mykhayloscherbak/psg14aemu/hw/psg14_emu/psg14_emu.pdf

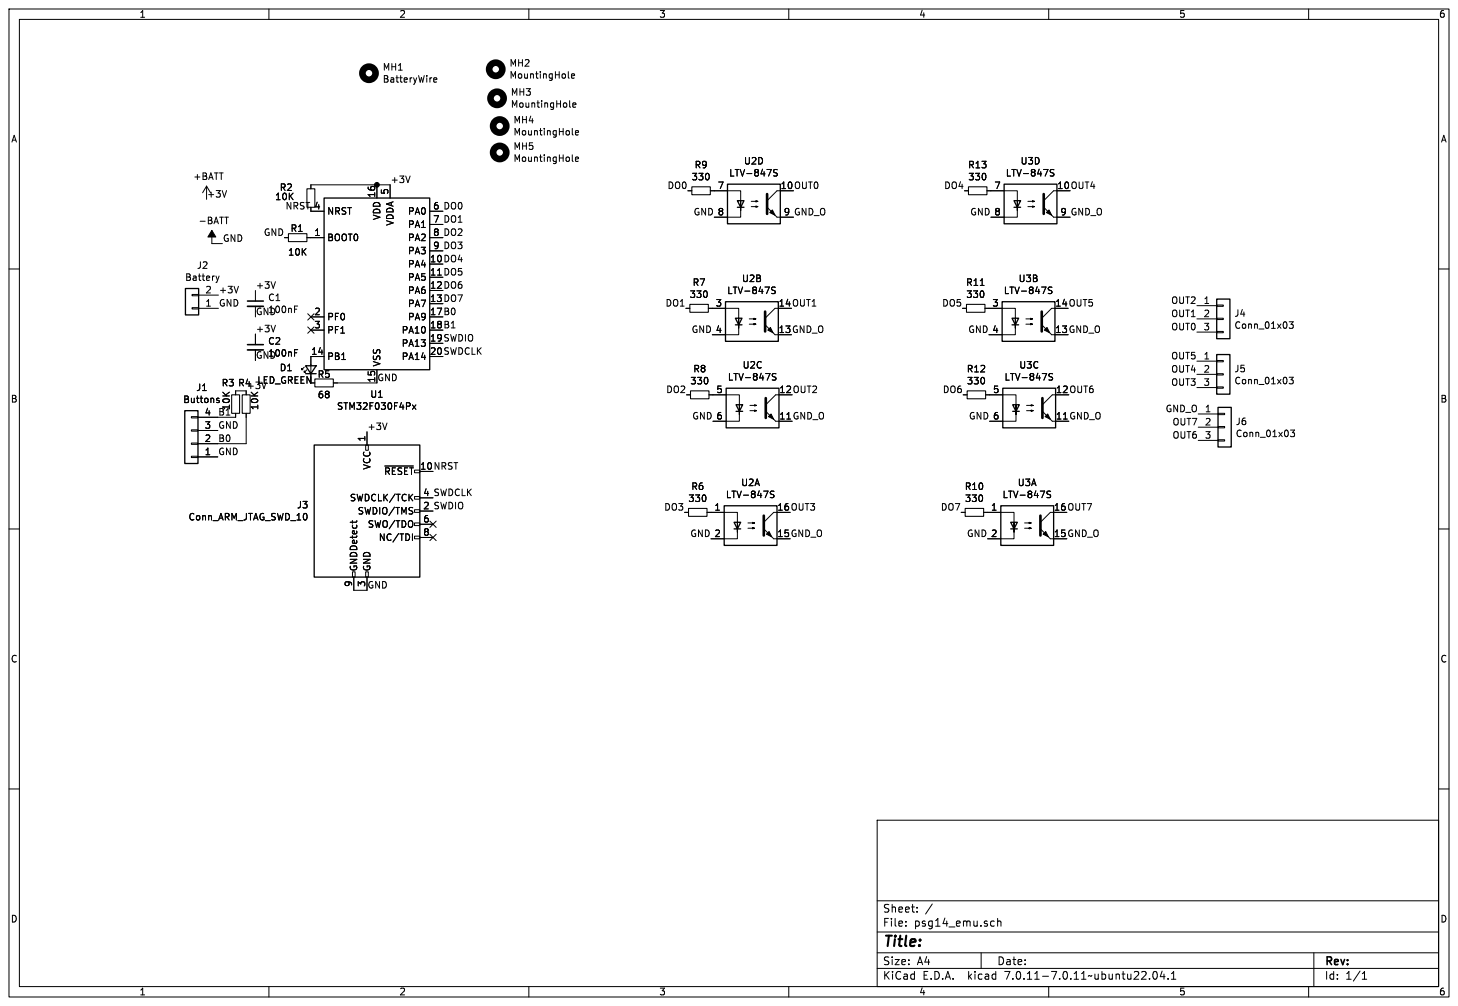
[picture p1: page 1]

3 SWDCLK/TCK 4 SWO/TDO 6 NC/TDI 8 GNDDetect 9 R1

1 ~{RESET}10 SWDIO/TMS 2 GND

3 SWDCLK/TCK 4 SWO/TDO 6 NC/TDI 8 GNDDetect 9

Id: 1/1 Title: File: psg14_emu.sch Sheet: /
