mykhayloscherbak/psg14aemu/hw/psg14a_power/psg14a_power.pdf

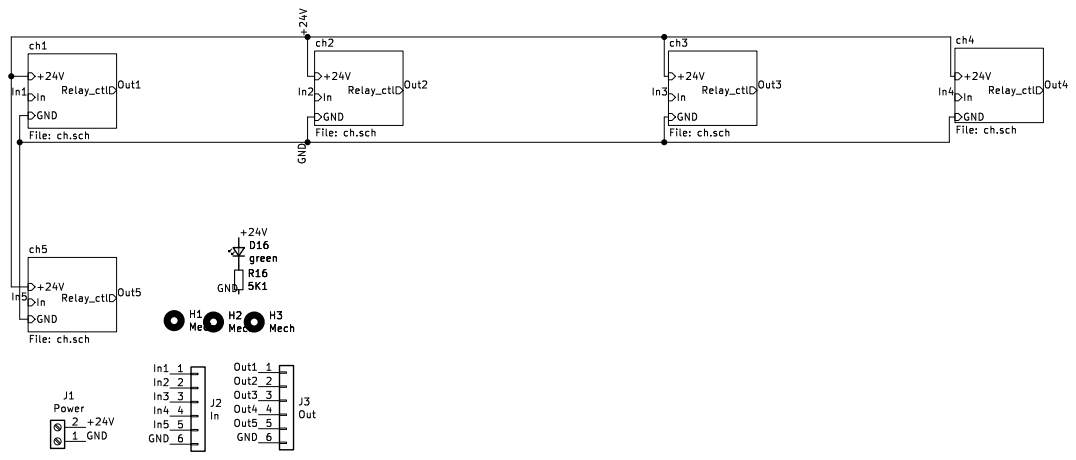
[picture p2: page 1]

In+24V Relay_ctl ch1 File: ch.sch GND

In+24V Relay_ctl ch2 File: ch.sch GND

Id: 1/6 Title: File: psg14a_power.sch Sheet: /

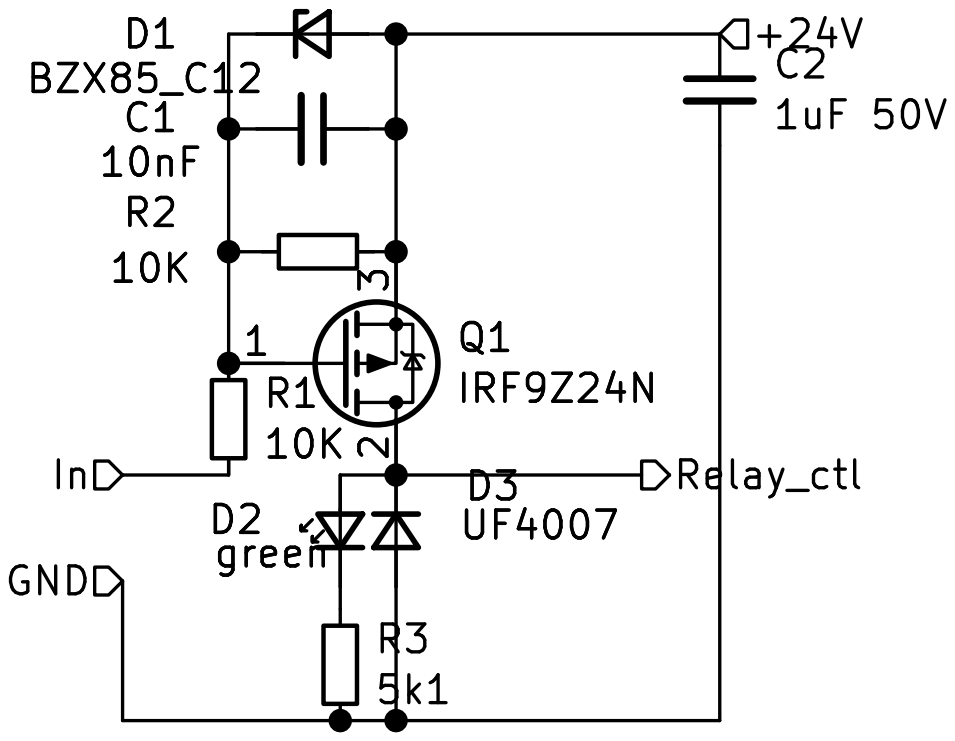
[picture p3: page 2]

Id: 2/6 Title: File: ch.sch Sheet: /ch1/

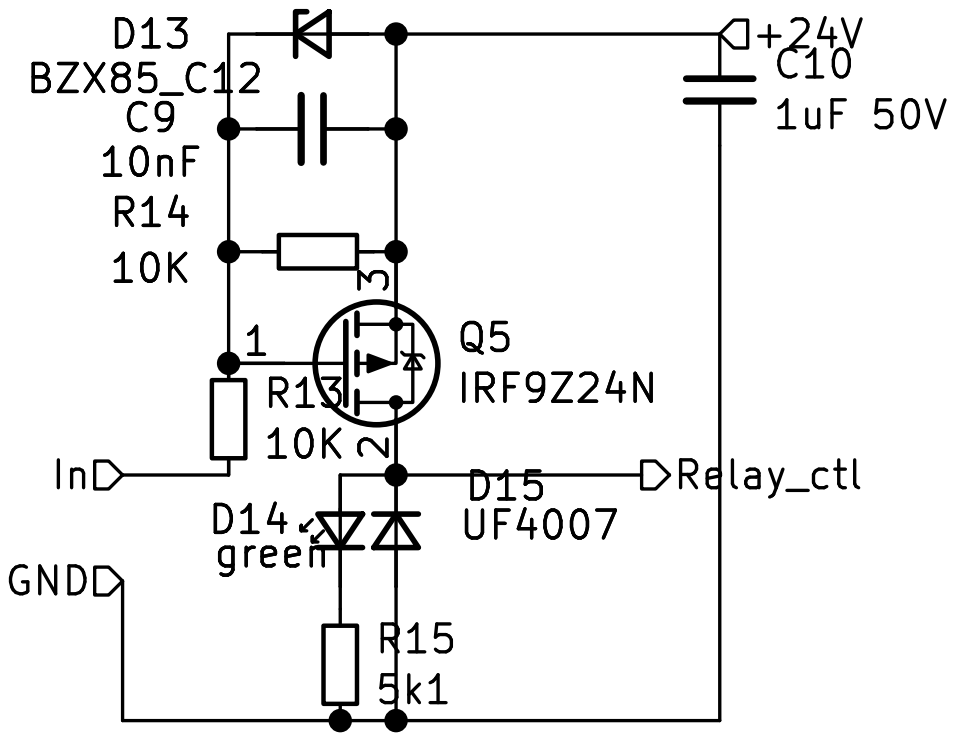
[picture p4: page 3]

Id: 3/6 Title: File: ch.sch Sheet: /ch5/

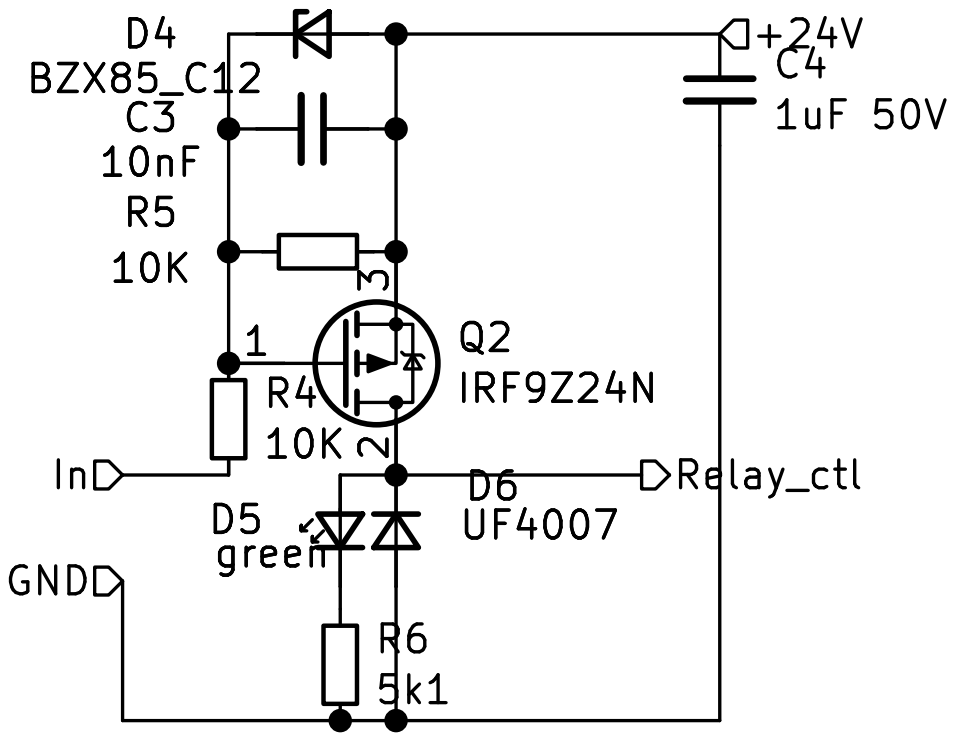
[picture p5: page 4]

Id: 4/6 Title: File: ch.sch Sheet: /ch2/

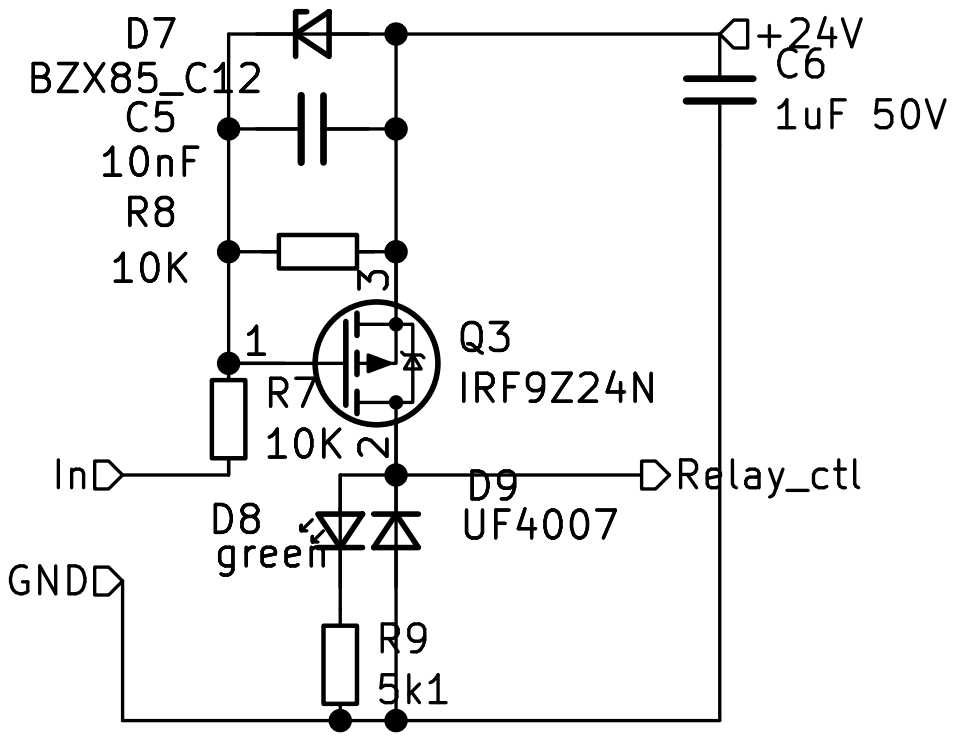
[picture p6: page 5]

Id: 5/6 Title: File: ch.sch Sheet: /ch3/

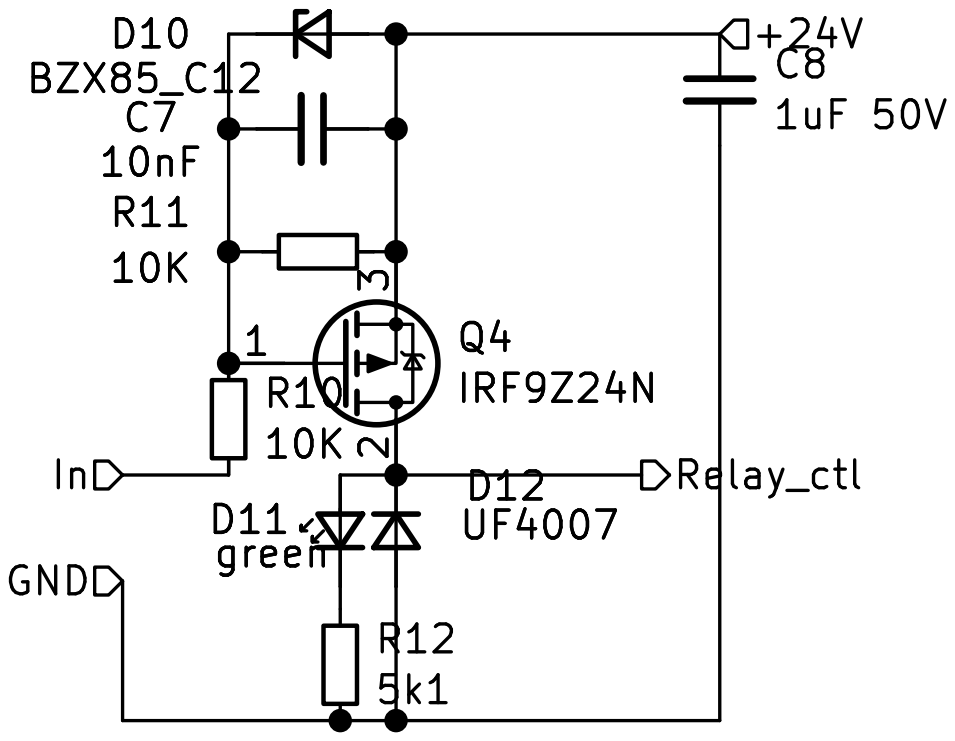
[picture p7: page 6]

Id: 6/6 Title: File: ch.sch Sheet: /ch4/
