mykhayloscherbak/psg14aemu/hw/psg14a_power/psg14a_power.kicad_pcb

## KiCad design hw/psg14a_power/psg14a_power.kicad_pcb (2024-09-21)

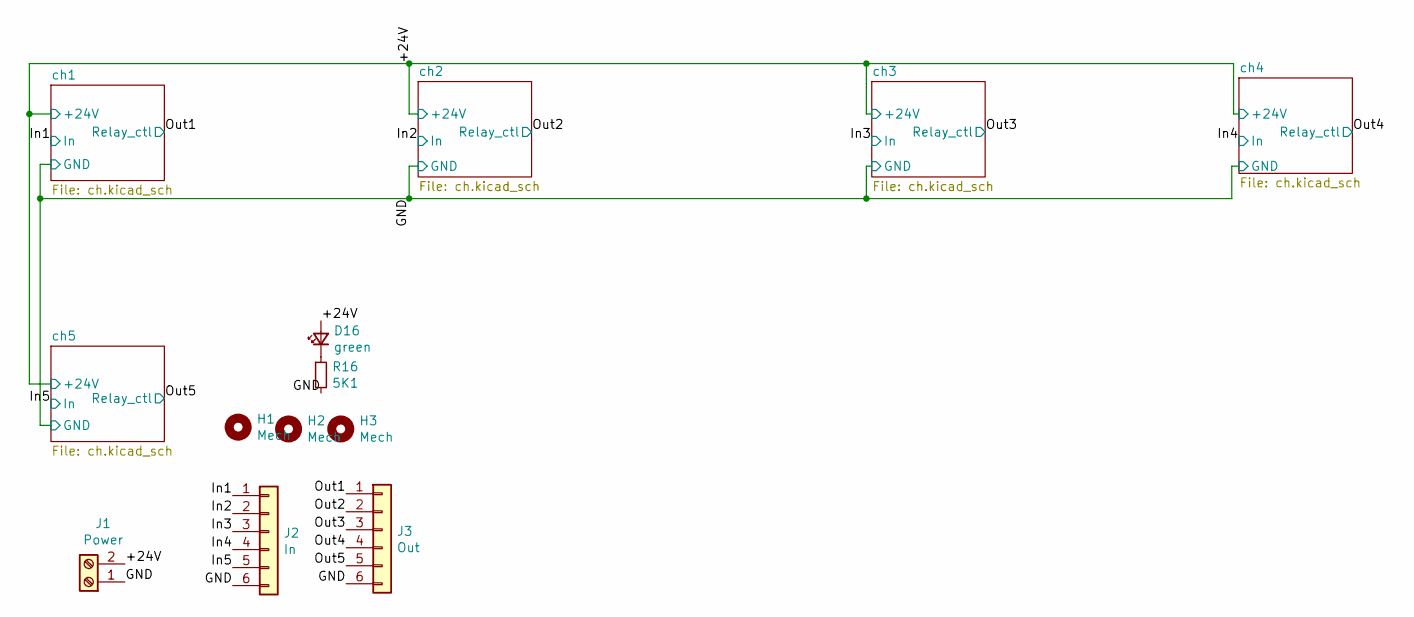
[picture p8: schematic psg14a_power.kicad_sch]

Parts:
D16: green; LED_0805_HandSoldering
H1, H2, H3: Mech; MountingHole_3.2mm_M3
J1: Power; TerminalBlock_Phoenix_PT-3.5mm_2pol
J2: In; TerminalBlock_Phoenix_MPT-2.54mm_6pol
J3: Out; TerminalBlock_Phoenix_MPT-2.54mm_6pol
R16: 5K1; R_0805_HandSoldering

Connections:
/+24V: D16.2 (A), J1.2; also elsewhere on the board
/GND: J1.1, J2.6, J3.6, R16.2; also elsewhere on the board
/In1: J2.1; also elsewhere on the board
/In2: J2.2; also elsewhere on the board
/In3: J2.3; also elsewhere on the board
/In4: J2.4; also elsewhere on the board
/In5: J2.5; also elsewhere on the board
/Out1: J3.1; also elsewhere on the board
/Out2: J3.2; also elsewhere on the board
/Out3: J3.3; also elsewhere on the board
/Out4: J3.4; also elsewhere on the board
/Out5: J3.5; also elsewhere on the board
unnamed: D16.1 (K), R16.1

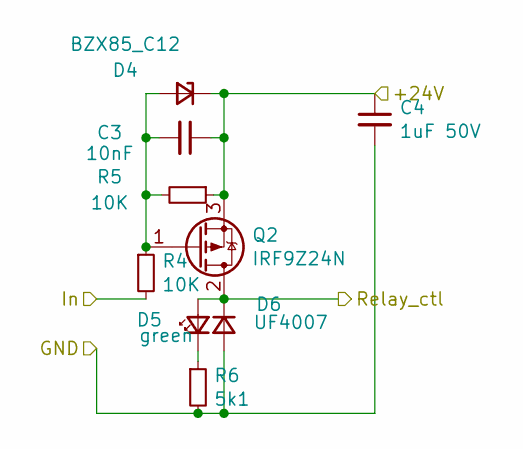
[picture p9: schematic ch.kicad_sch]

Parts:
C3: 10nF; C_0805_HandSoldering
C4: 1uF 50V; C_0805_HandSoldering
D4: BZX85_C12; D_DO-41_SOD81_P5.08mm_Vertical_AnodeUp
D5: green; LED_0805_HandSoldering
D6: UF4007; D_DO-41_SOD81_P5.08mm_Vertical_AnodeUp
Q2: IRF9Z24N; TO-220-3_Vertical
R4, R5: 10K; R_0805_HandSoldering
R6: 5k1; R_0805_HandSoldering

Connections:
/+24V: C3.1, C4.1, D4.2 (K), Q2.3 (S), R5.1; also elsewhere on the board
/GND: C4.2, D6.2 (A), R6.2; also elsewhere on the board
/In2: R4.2; also elsewhere on the board
/Out2: D5.2 (A), D6.1 (K), Q2.2 (D); also elsewhere on the board
unnamed: C3.2, D4.1 (A), Q2.1 (G), R4.1, R5.2
unnamed: D5.1 (K), R6.1

Parts of its further copies:
C1, C5, C7, C9: 10nF; C_0805_HandSoldering
C2, C6, C8, C10: 1uF 50V; C_0805_HandSoldering
D1, D7, D10, D13: BZX85_C12; D_DO-41_SOD81_P5.08mm_Vertical_AnodeUp
D2, D8, D11, D14: green; LED_0805_HandSoldering
D3, D9, D12, D15: UF4007; D_DO-41_SOD81_P5.08mm_Vertical_AnodeUp
Q1, Q3, Q4, Q5: IRF9Z24N; TO-220-3_Vertical
R1, R2, R7, R8, R10, R11, R13, R14: 10K; R_0805_HandSoldering
R3, R9, R12, R15: 5k1; R_0805_HandSoldering

Connections of its further copies:
/+24V: C1.1, C2.1, C5.1, C6.1, C7.1, C8.1, C9.1, C10.1, D1.2 (K), D7.2 (K), D10.2 (K), D13.2 (K), Q1.3 (S), Q3.3 (S), Q4.3 (S), Q5.3 (S), R2.1, R8.1, R11.1, R14.1; also elsewhere on the board
/GND: C2.2, C6.2, C8.2, C10.2, D3.2 (A), D9.2 (A), D12.2 (A), D15.2 (A), R3.2, R9.2, R12.2, R15.2; also elsewhere on the board
/In1: R1.2; also elsewhere on the board
/In3: R7.2; also elsewhere on the board
/In4: R10.2; also elsewhere on the board
/In5: R13.2; also elsewhere on the board
/Out1: D2.2 (A), D3.1 (K), Q1.2 (D); also elsewhere on the board
/Out3: D8.2 (A), D9.1 (K), Q3.2 (D); also elsewhere on the board
/Out4: D11.2 (A), D12.1 (K), Q4.2 (D); also elsewhere on the board
/Out5: D14.2 (A), D15.1 (K), Q5.2 (D); also elsewhere on the board
unnamed: C1.2, D1.1 (A), Q1.1 (G), R1.1, R2.2
unnamed: D2.1 (K), R3.1
unnamed: C5.2, D7.1 (A), Q3.1 (G), R7.1, R8.2
unnamed: D8.1 (K), R9.1
unnamed: C7.2, D10.1 (A), Q4.1 (G), R10.1, R11.2
unnamed: D11.1 (K), R12.1
unnamed: C9.2, D13.1 (A), Q5.1 (G), R13.1, R14.2
unnamed: D14.1 (K), R15.1

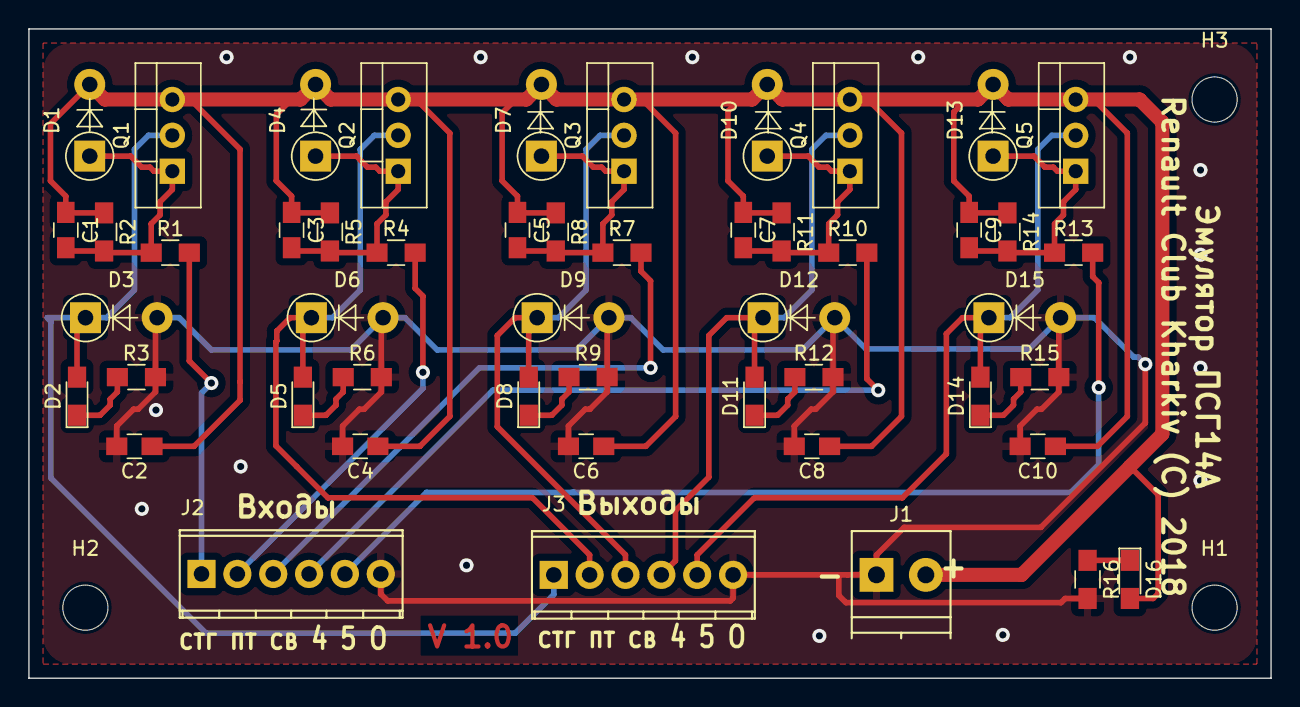
[picture p10: board psg14a_power.kicad_pcb from above]

Board: 2 copper layers, 88.0 x 46.0 mm, 53 parts (0 on the bottom side), 23 nets.
