mykhayloscherbak/psg14aemu/hw/psg14_emu/psg14_emu.kicad_pcb

## KiCad design hw/psg14_emu/psg14_emu.kicad_pcb (2018-10-17)

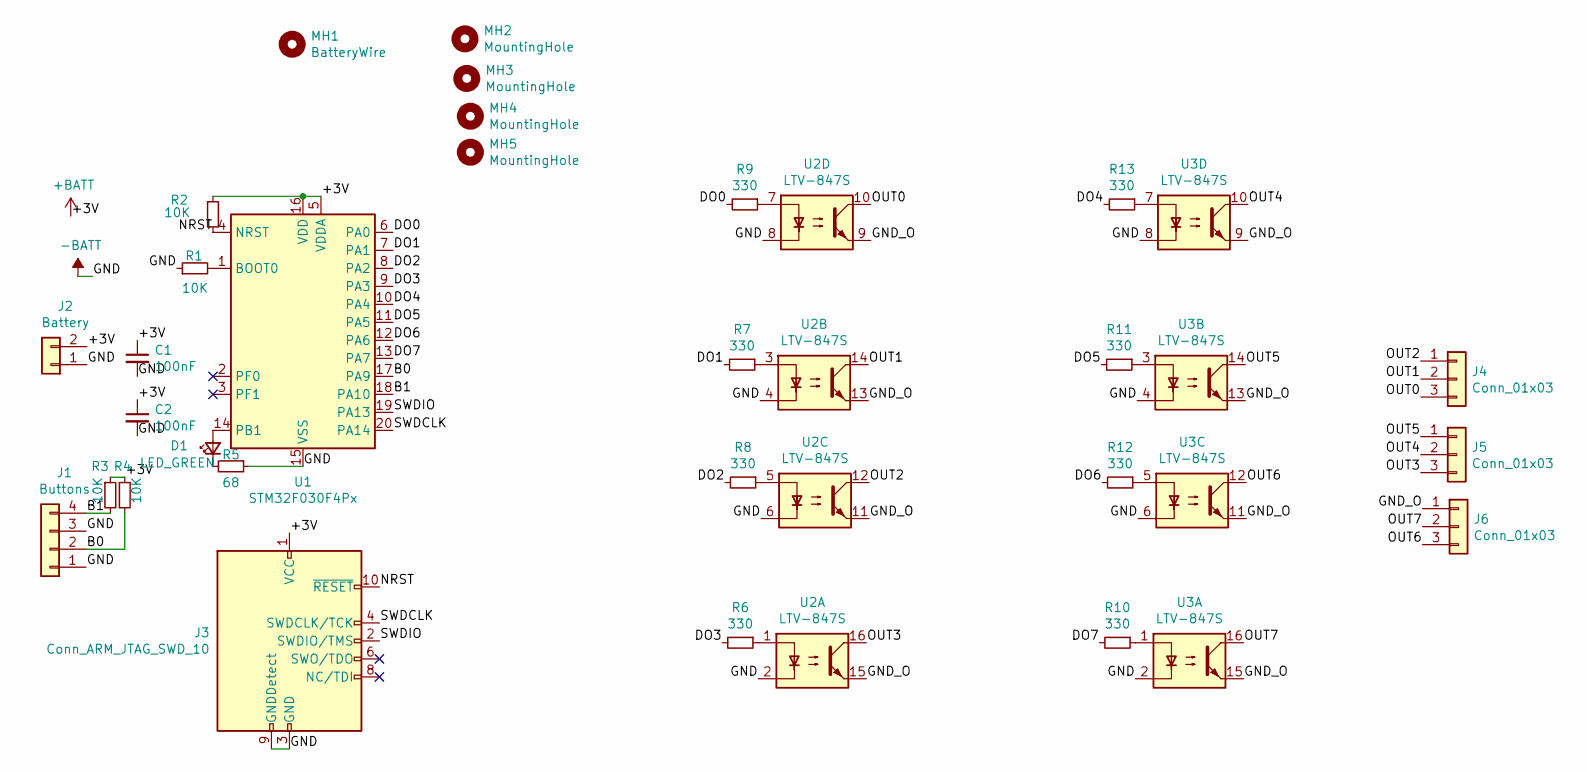
[picture p11: schematic psg14_emu.kicad_sch]

Parts:
C1, C2: 100nF; C_0805_HandSoldering
D1: LED_GREEN; LED_D5.0mm
J1: Buttons; TerminalBlock_bornier-4_P5.08mm
J2: Battery; Pin_Header_Straight_1x02_Pitch2.54mm
J3: Conn_ARM_JTAG_SWD_10; Pin_Header_Straight_2x05_Pitch1.27mm_SMD
J4, J5, J6: Conn_01x03; TerminalBlock_bornier-3_P5.08mm
MH1: BatteryWire; MountingHole_2.5mm
MH2, MH3, MH4, MH5: MountingHole; MountingHole_3.2mm_M3
R1, R2, R3, R4: 10K; R_0805_HandSoldering
R5: 68; R_0805_HandSoldering
R6, R7, R8, R9, R10, R11, R12, R13: 330; R_0805_HandSoldering
U1: STM32F030F4Px; TSSOP-20_4.4x6.5mm_Pitch0.65mm
U2, U3: LTV-847S; SMDIP-16_W9.53mm_Clearance8mm

Connections:
+BATT: C1.1, C2.1, J2.2, J3.1 (VCC), R2.1, R3.1, R4.1, U1.5 (VDDA), U1.16 (VDD)
-BATT: C1.2, C2.2, J1.1, J1.3, J2.1, J3.3 (GND), J3.5 (GND), J3.9 (GNDDetect), R1.1, R5.1, U1.15 (VSS), U2.2, U2.4, U2.6, U2.8, U3.2, U3.4, U3.6, U3.8
/B0: J1.2, R4.2, U1.17 (PA9)
/B1: J1.4, R3.2, U1.18 (PA10)
/DO0: R9.2, U1.6 (PA0)
/DO1: R7.2, U1.7 (PA1)
/DO2: R8.2, U1.8 (PA2)
/DO3: R6.2, U1.9 (PA3)
/DO4: R13.2, U1.10 (PA4)
/DO5: R11.2, U1.11 (PA5)
/DO6: R12.2, U1.12 (PA6)
/DO7: R10.2, U1.13 (PA7)
/GND_O: J6.1, U2.9, U2.11, U2.13, U2.15, U3.9, U3.11, U3.13, U3.15
/NRST: J3.10 (~RESET), R2.2, U1.4 (NRST)
/OUT0: J4.3, U2.10
/OUT1: J4.2, U2.14
/OUT2: J4.1, U2.12
/OUT3: J5.3, U2.16
/OUT4: J5.2, U3.10
/OUT5: J5.1, U3.14
/OUT6: J6.3, U3.12
/OUT7: J6.2, U3.16
/SWDCLK: J3.4 (SWDCLK/TCK), U1.20 (PA14)
/SWDIO: J3.2 (SWDIO/TMS), U1.19 (PA13)
unnamed: D1.1 (K), R5.2
unnamed: D1.2 (A), U1.14 (PB1)
unnamed: R1.2, U1.1 (BOOT0)
unnamed: R6.1, U2.1
unnamed: R7.1, U2.3
unnamed: R8.1, U2.5
unnamed: R9.1, U2.7
unnamed: R10.1, U3.1
unnamed: R11.1, U3.3
unnamed: R12.1, U3.5
unnamed: R13.1, U3.7

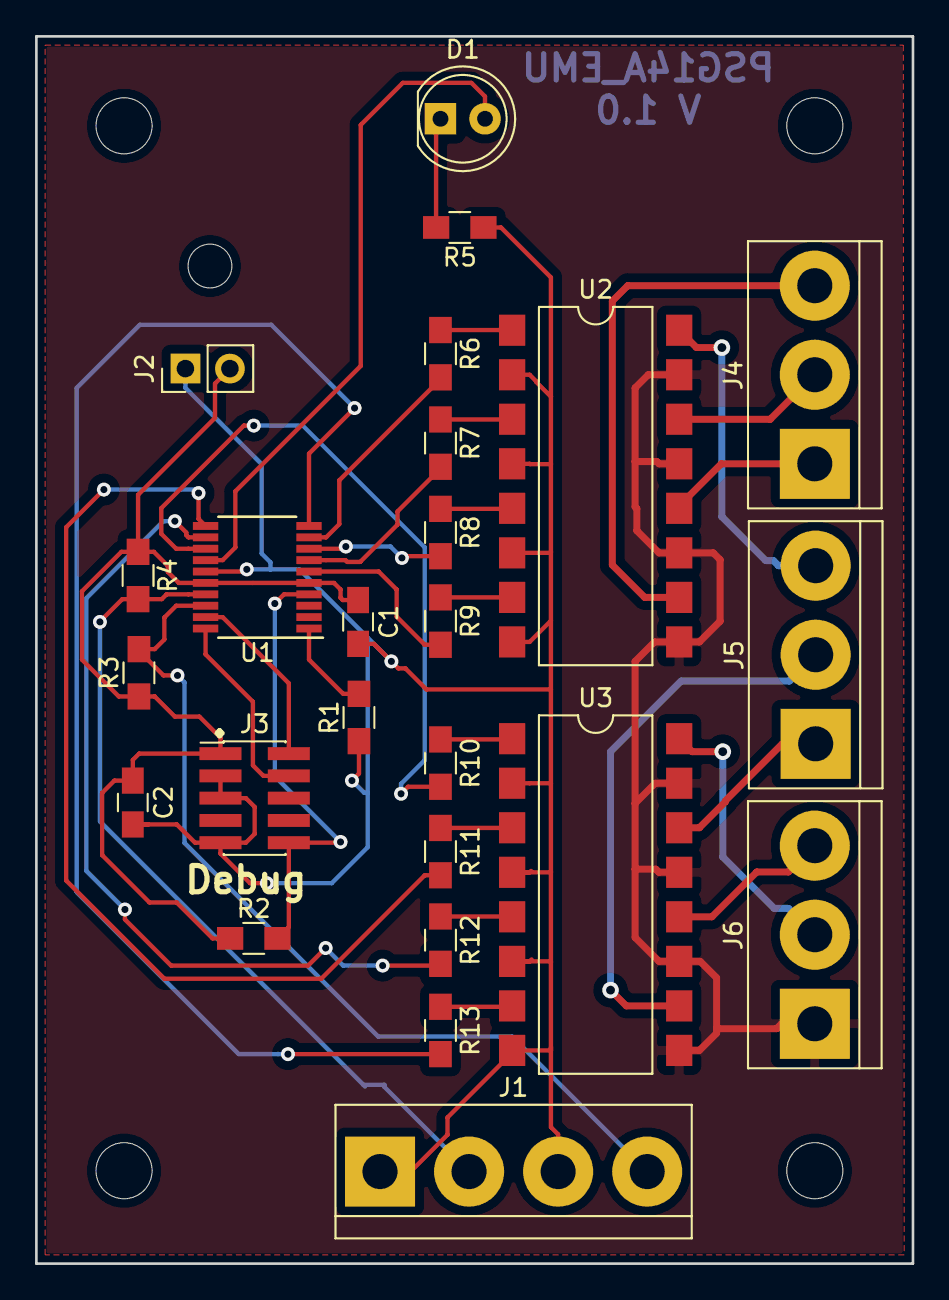
[picture p12: board psg14_emu.kicad_pcb from above]

Board: 2 copper layers, 50.0 x 70.0 mm, 30 parts (0 on the bottom side), 35 nets.
