mykhayloscherbak/psg14aemu/(commit log)

2018-10-13 [psg14_emu] project stared
    [psg14_emu.kicad_pcb, psg14_emu.sch]
2018-10-14 [psg14_emu] Schematics ready
    [psg14_emu.sch]
2018-10-16 [psg14_emu] Assignements
    [psg14_emu.sch]
2018-10-17 [psg14_emu] PCB tracing
    [psg14_emu.sch]
2018-10-17 [psg14_emu] Ready for production
    [psg14_emu-B.Cu.gbl, psg14_emu-B.Mask.gbs, psg14_emu-B.SilkS.gbo, psg14_emu-Edge.Cuts.gm1, psg14_emu-F.Cu.gtl, psg14_emu-F.Mask.gts, psg14_emu-F.SilkS.gto, psg14_emu.drl]
2018-10-17 [psg14_emu] Sent to production
    [psg14_emu-B.Cu.gbl, psg14_emu-B.Mask.gbs, psg14_emu-B.SilkS.gbo, psg14_emu-Edge.Cuts.gm1, psg14_emu-F.Cu.gtl, psg14_emu-F.Mask.gts, psg14_emu-F.SilkS.gto, psg14_emu.drl]
2018-10-17 [psg14_emu]Moved to upper dir
    [psg14_emu-B.Cu.gbl, psg14_emu-B.Mask.gbs, psg14_emu-B.SilkS.gbo, psg14_emu-Edge.Cuts.gm1, psg14_emu-F.Cu.gtl, psg14_emu-F.Mask.gts, psg14_emu-F.SilkS.gto, psg14_emu.drl]
2018-10-20 [psg14_emu] BOM added
    [psg14_emu.csv]
2018-11-09 [psg14_emu] Bom changed
    [psg14_emu.csv]
2018-12-01 [psg14a_power]First commit
    [psg14a_power.kicad_pcb, psg14a_power.sch]
2018-12-10 [psg14a_power]Schematics finished
    [psg14a_power.kicad_pcb, psg14a_power.sch]
2018-12-12 [psg14a-power]Components placed
    [psg14a_power.kicad_pcb]
2018-12-13 [psg14a] looking how to copy blocks
    [psg14a_power.kicad_pcb, psg14a_power.sch]
2018-12-14 [psg14a_power]New route added
    [psg14a_power.kicad_pcb, psg14a_power.sch]
2018-12-16 [psg14a_power] Switch to multiple sheets layout
    [ch.sch, psg14a_power.sch]
2018-12-18 [psg14a_power] Ready for replication which does not work ;-)
    [ch.sch, psg14a_power.kicad_pcb, psg14a_power.sch]
2018-12-18 [psg14a_power]New components placement
    [psg14a_power.kicad_pcb]
2018-12-19 [psg14a_power] New layout
    [psg14a_power.kicad_pcb]
2018-12-20 [psg14a_power] New layout again
    [psg14a_power.kicad_pcb]
2018-12-21 [psg14a_power] Routing in progress
    [psg14a_power.kicad_pcb]
2018-12-22 [psg14a_power]Ready for review by Ioan the Greatest
    [ch.sch, psg14a_power.kicad_pcb, psg14a_power.sch]
2018-12-22 [Psg14a_power] Ioan the Greatest was drunk. Ready for production
    [psg14a_power-B.Cu.gbl, psg14a_power-B.Mask.gbs, psg14a_power-B.SilkS.gbo, psg14a_power-Edge.Cuts.gm1, psg14a_power-F.Cu.gtl, psg14a_power-F.Mask.gts, psg14a_power-F.SilkS.gto, psg14a_power.drl]
2019-01-01 [psg14a_emu]Timers init added. GPIO started
2019-01-01 [psg14a_emu]Timers init added. GPIO started2
2019-01-02 [psg14a_emu]Gpio works for LED
2019-01-02 [psg14a_emu]Led blink works now
2019-01-06 [psg14a_emu]Tables added but do not work
    [control_tables.c, control_tables.h, led_control.c, led_control.h, main.c, main_outputs.c]
2019-01-09 [psg14a_emu]Modes switching works now. Sleep TBD
2019-02-09 [psg14a_power] bom added
    [psg14a_power.csv]
2019-04-27 [psg14a_emu]Added 500ms pause after button is pressed before start mode. Sleep mode still does not work
    [buttons.c, buttons.h, gpio_exti.c, main.c]
2020-01-25 [psg14_emu]Channel for 36v added
2020-02-06 [start128]Gerbers and schematics added for start128
2024-08-04 Renaming dirs
    [ch.sch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]
2024-09-16 Develop/adding doxygen (#1)
    * Doxygen fixed
    * Plantuml added
    [buttons.c, control_tables.c, led_control.c, led_control.h, main.c, main_outputs.c]
2024-09-21 Develop/hw (#2)
    * Converted to Kicad 7.x
    * Zener diode wrong footprint fixed
    [ch.kicad_sch, psg14_emu.kicad_sch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]
