mykhayloscherbak/psg14aemu/(notices)

Notices in the files:
hw/psg14a_power/psg14a_power.kicad_pcb:
Renault Club Kharkiv (C) 2018
